AlexPedre/TrenoLEGO/images/schematics/README.md

# *images/schemstics* directory
This directory contains the schematics for *TrenoLEGO* hub.
