AlexPedre/TrenoLEGO/data/Html/js/README.md

# *data/Html/js* directory
In the future, this will contain JavaScript libraries used to extend the features of *TrenoLEGO*.
Currently, it contains only the Acorn library (not yet in use), which is intended to support the implementation of
scripting capabilities.
