AlexPedre/TrenoLEGO/html/README.md

# *html* directory
This directory includes the sources for bundles and media. If you want to modify the GUI and the media, edit the files in this
directory tree, than build the bundles with *scripts/bundle_all.cmd* or *scripts/bundle_all.sh*.  
Here is the directory tree description:

- **/**  
  root of the directory. It contains the *Html* files.
- **css**  
  stylesheet directory.
- **img**  
  image directory. It includes images in *ico*, *svg* and *png* formats.
- **js**  
  JavaScript directory. It contains JavaScript used in the *Html* pages of TrenoLEGO graphic interface.
- **mus**  
  music directory. It contains *MIDI* files.
- **snd**  
  sound effect directory. It includes the sound effects in *mp3* format (VBR, 48KHz, mono, Audacity VBR Quality 9) and the related
  icons in *svg* format used to build the buttons of the sound FX side bar. Here you can add/remove/change the sound effects.
