AlexPedre/TrenoLEGO/images/hardware/motor_103-1.jpg

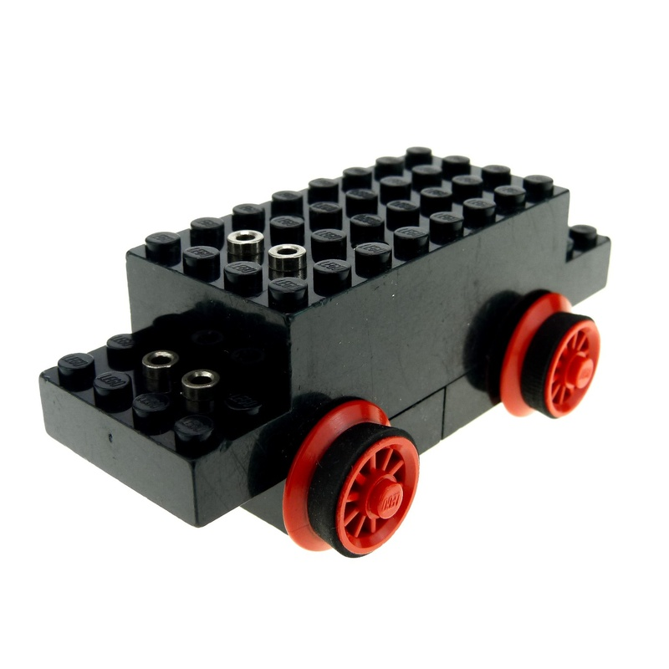
images/hardware/motor_103-1.jpg
