AlexPedre/TrenoLEGO/images/hardware/motor_107.jpg

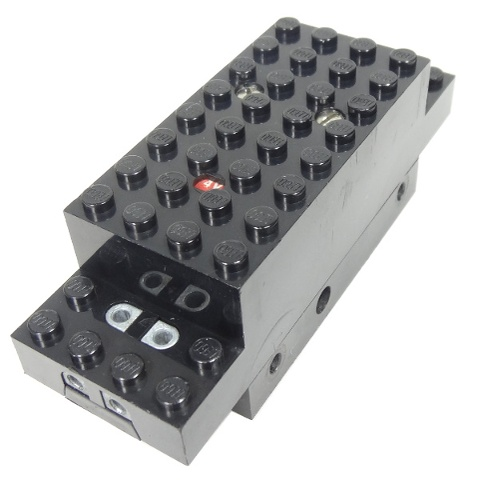
images/hardware/motor_107.jpg
