AlexPedre/TrenoLEGO/images/hardware/motor_88002.jpg

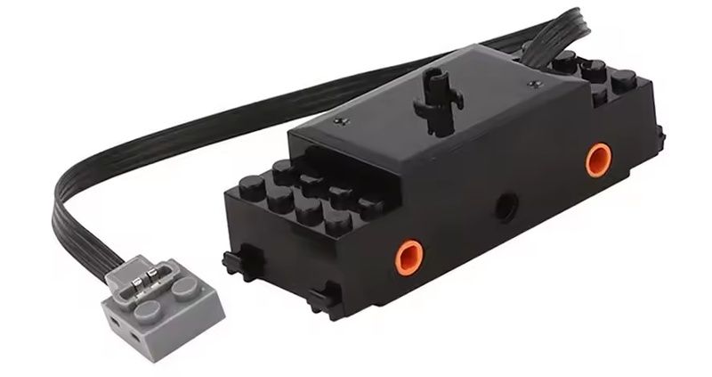
images/hardware/motor_88002.jpg
