AlexPedre/TrenoLEGO/images/hubs/161_comp.jpg

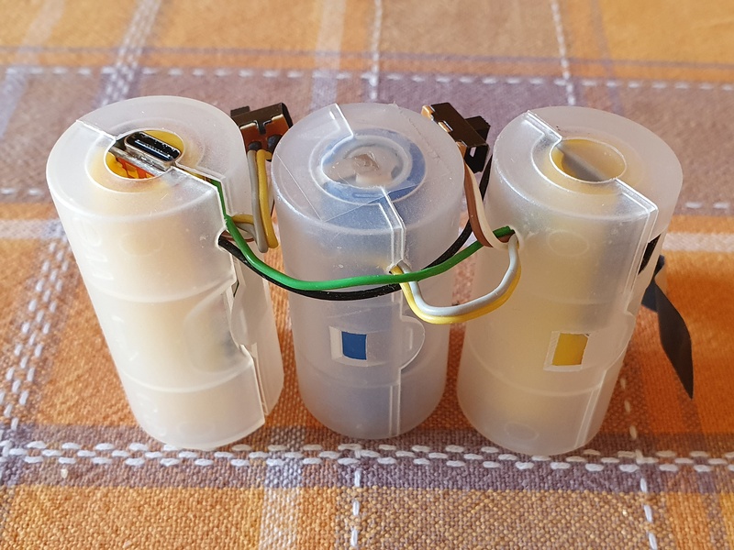
images/hubs/161_comp.jpg
