AlexPedre/TrenoLEGO/images/hubs/161_side.jpg

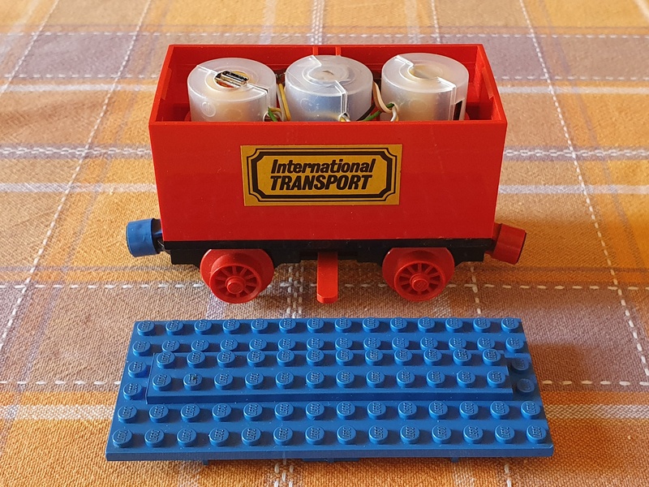
images/hubs/161_side.jpg
