AlexPedre/TrenoLEGO/images/hubs/161_top.jpg

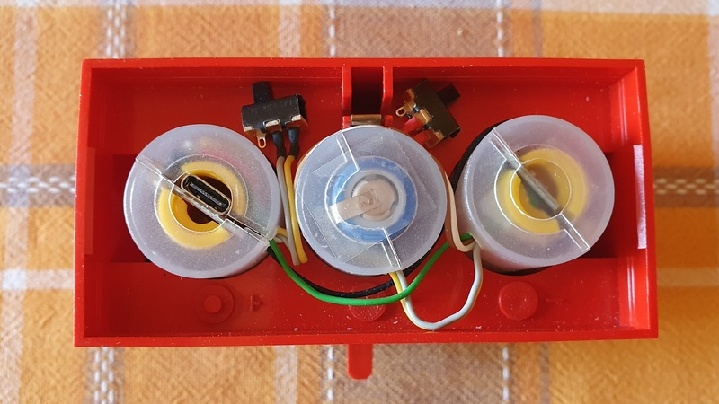
images/hubs/161_top.jpg
