AlexPedre/TrenoLEGO/images/hubs/88000_side.jpg

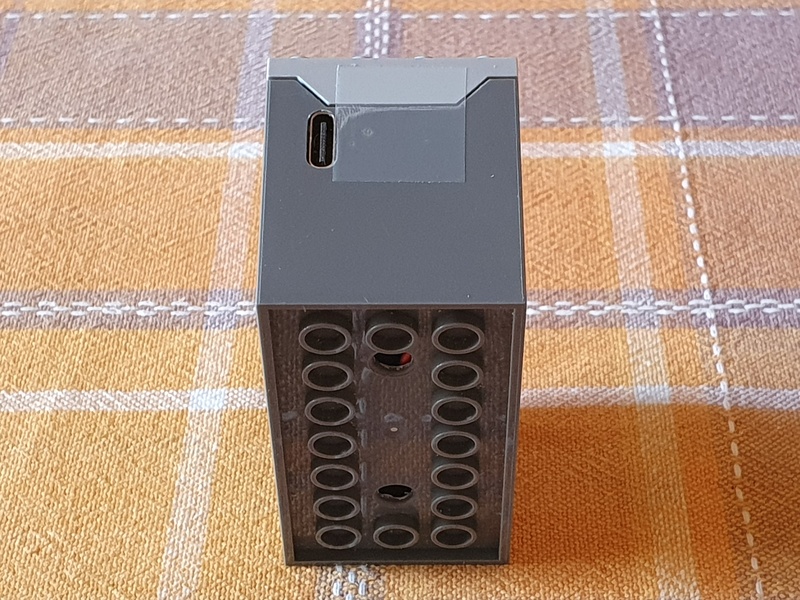
images/hubs/88000_side.jpg
