AlexPedre/TrenoLEGO/images/hubs/88000_top.jpg

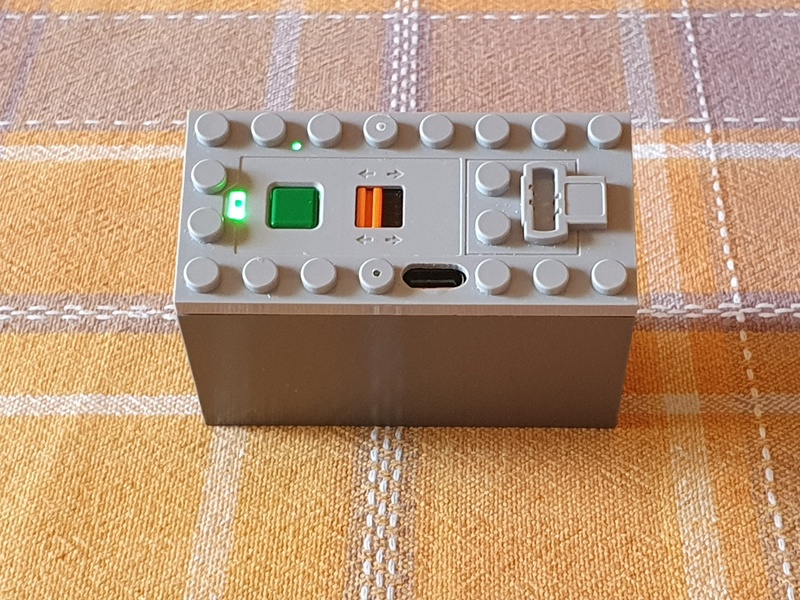
images/hubs/88000_top.jpg
