AlexPedre/TrenoLEGO/images/schematics/ESP32-C3.png

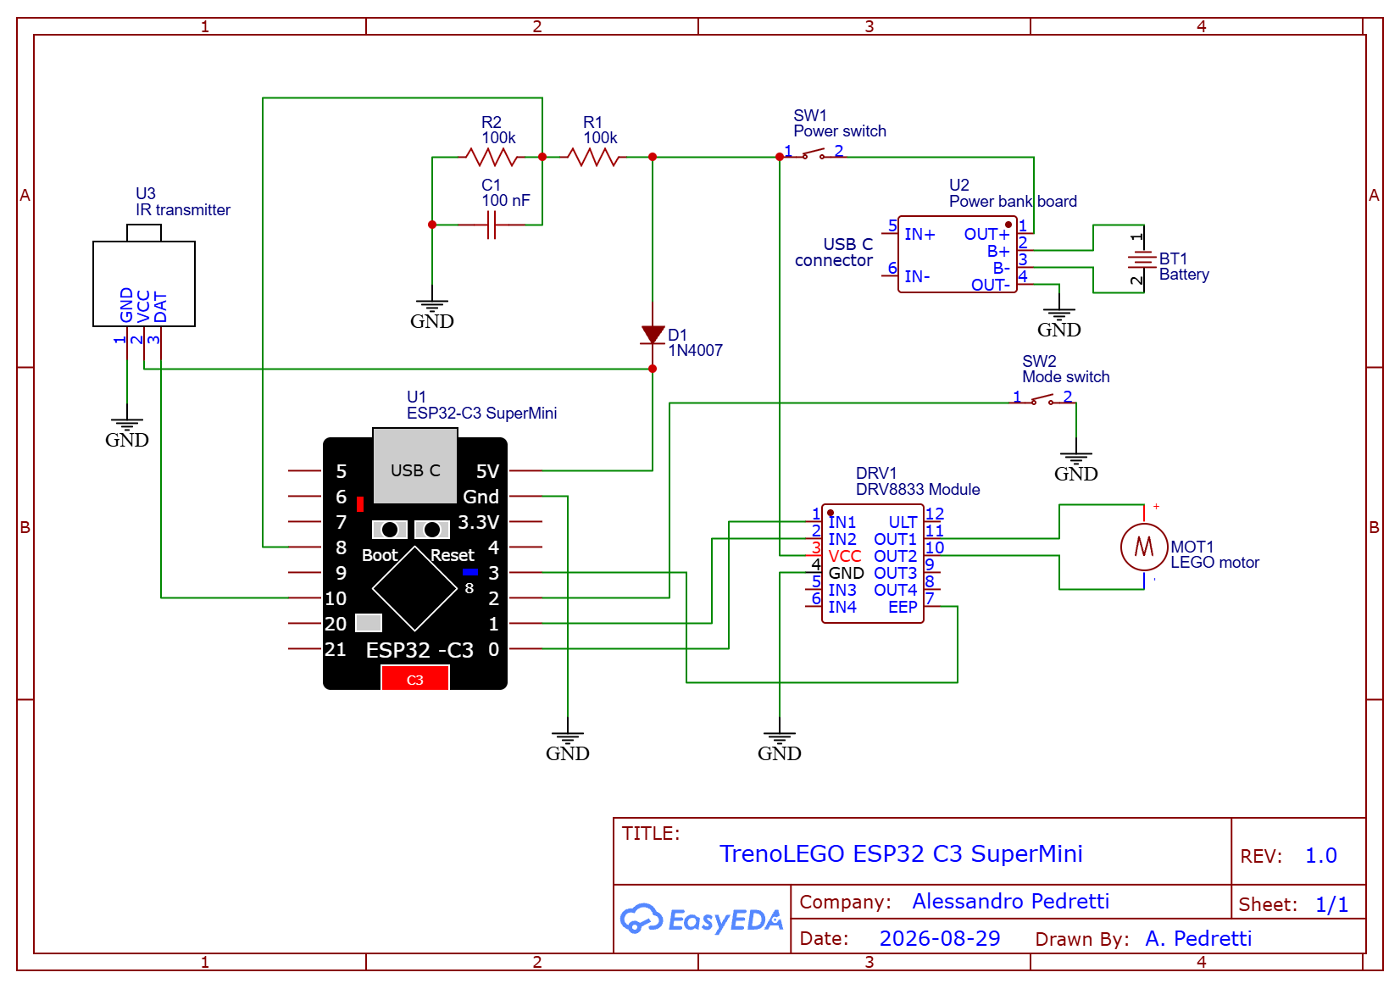
images/schematics/ESP32-C3.png
