AlexPedre/TrenoLEGO/images/schematics/ESP32-S3.png

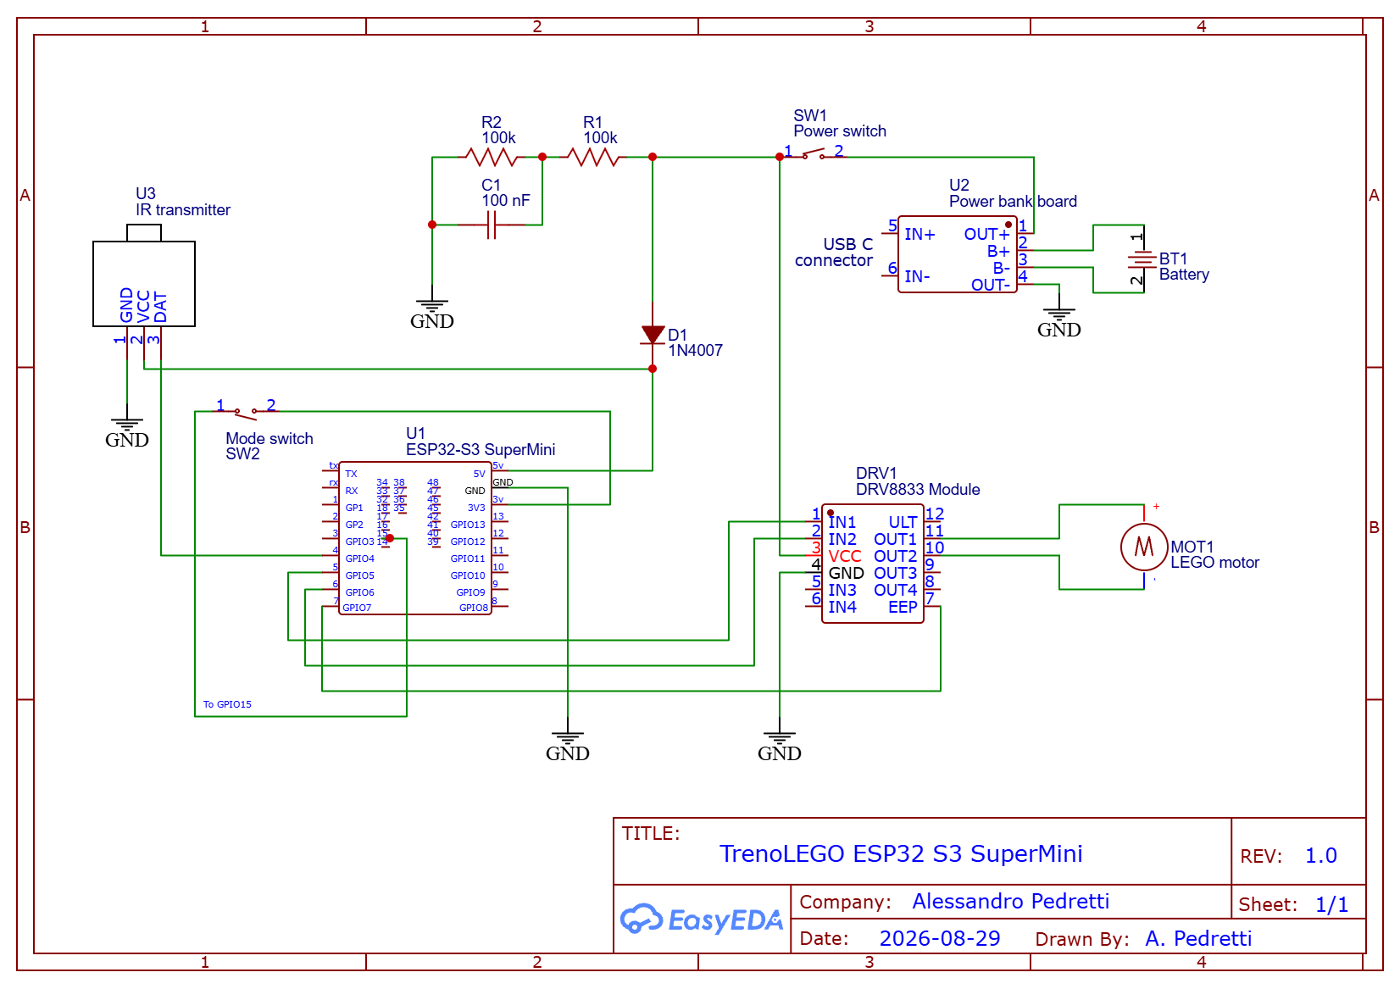
images/schematics/ESP32-S3.png
