AlexPedre/TrenoLEGO/images/schematics/NodeMCU.png

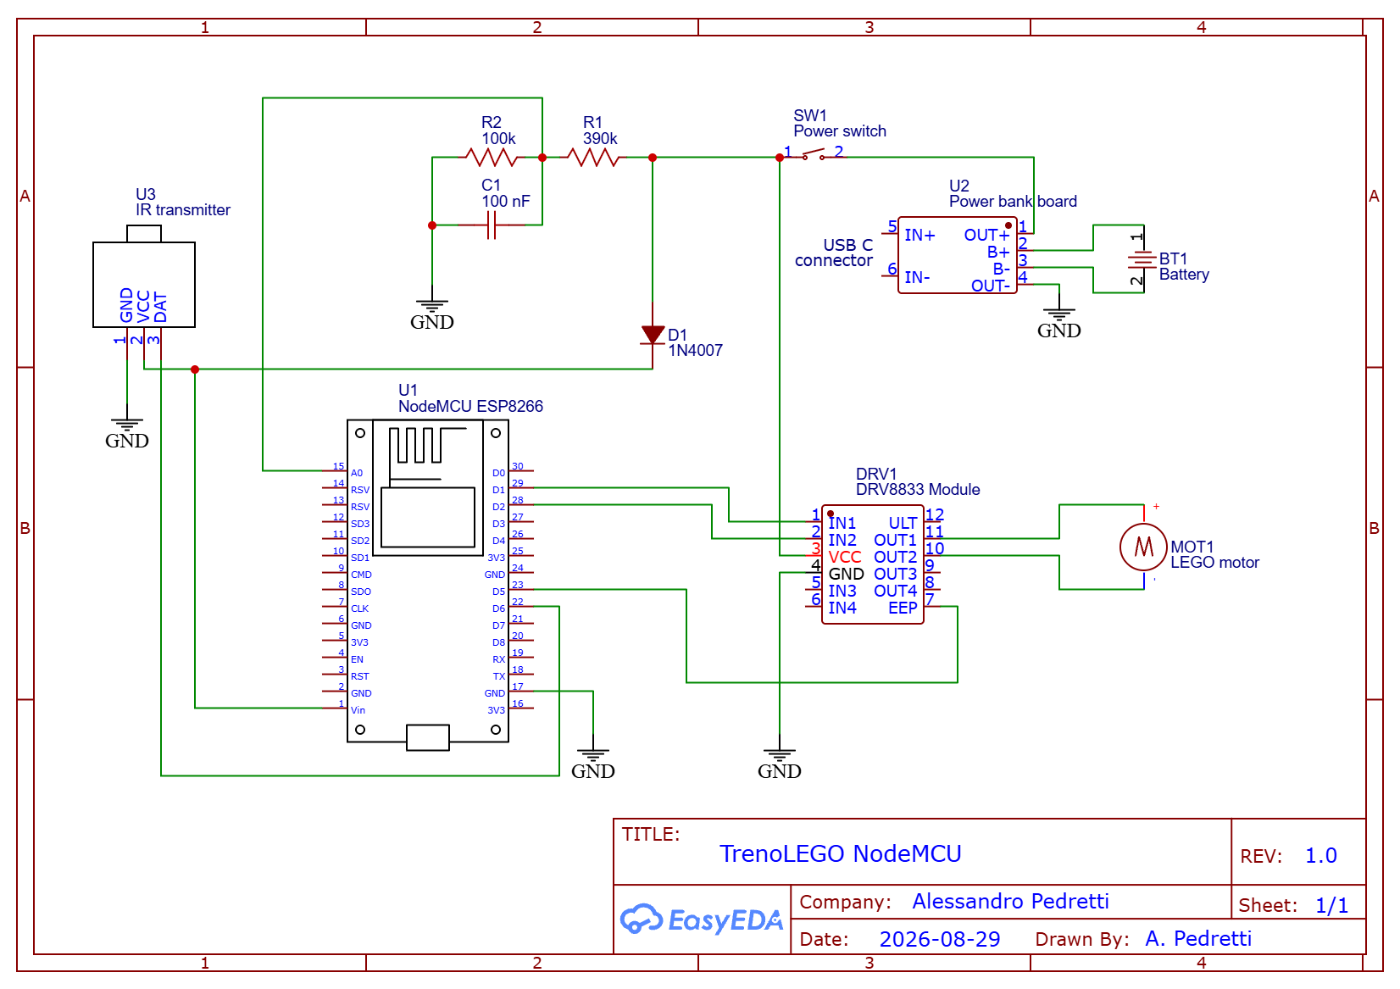
images/schematics/NodeMCU.png
