AlexPedre/TrenoLEGO/images/video/video_01.jpg

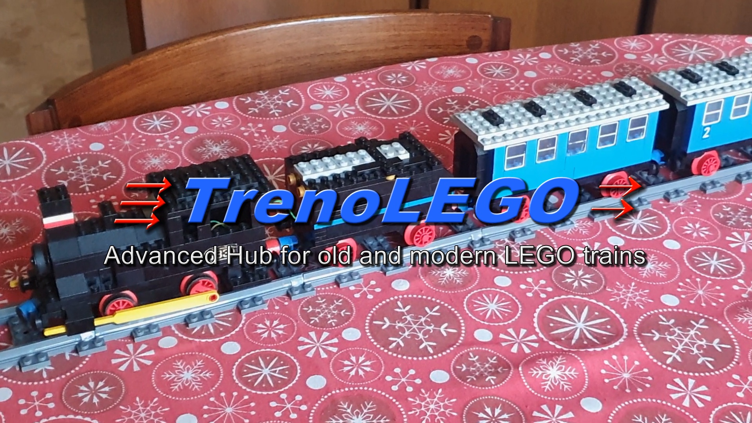
images/video/video_01.jpg
