AlexPedre/TrenoLEGO/images/hubs/88000_installed.jpg

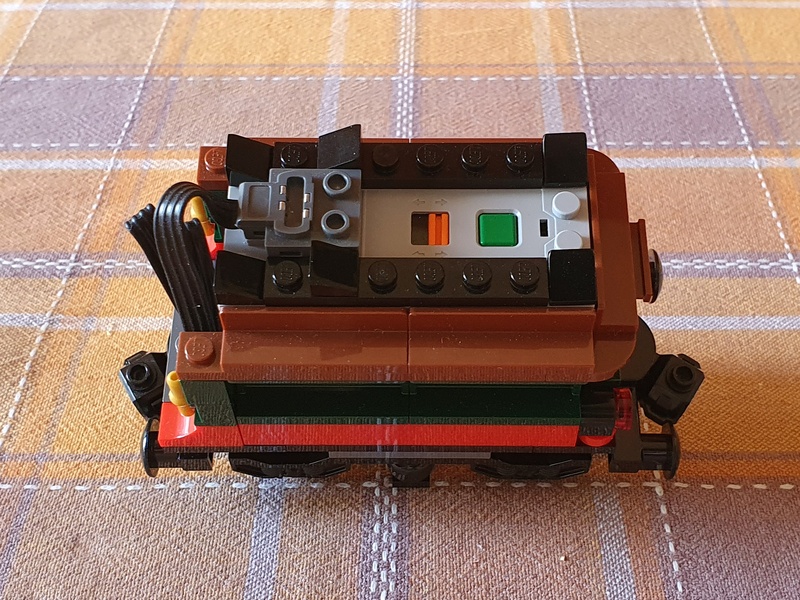
images/hubs/88000_installed.jpg
