AlexPedre/TrenoLEGO/credentials.h

/****************************************
**** TrenoLEGO - Default credentials ****
**** (c) 2026, Alessandro Pedretti   ****
****************************************/


/**** Administrator credentials ****/

# define  TR_ADMIN_USER     "admin"
# define  TR_ADMIN_PASS     "admin"

/**** MQTT ****/

#define  TR_MQTT_SERVER     "MQTT-Server"
#define  TR_MQTT_PORT       1883
#define  TR_MQTT_USER       "MQTT-User"
#define  TR_MQTT_PASS       "MQTT-Password"

/**** NTP ****/

#define  TR_NTP_SERVER      "ntp1.inrim.it"
#define  TR_TIMEZONE        "CET-1CEST,M3.5.0/02,M10.5.0/03"

/**** WiFi ****/

#define  TR_WIFI_SSID       "WiFi_SSID"
#define  TR_WIFI_PASS       "WiFi_Password"
